Mateo-Opertti/ECU32/hardware/pcb/README.md

# PCB layout

| Archivo | Contenido |
|---|---|
| `ECU32_PCB_Layout.pdf` | Página 1: vista top (composite). Página 2: vista bottom |

Las capturas en PNG que se muestran en el README principal están en [`docs/images/pcb/`](../../docs/images/pcb/).

**Datos de la placa:** 2 capas, ~150 × 150 mm, fabricada en JLCPCB.

## Cómo regenerarlo

- Desde Altium: OutJob → **Documentation Outputs → PCB Prints**, salida a PDF.
- Para un dibujo de armado: **Assembly Outputs → Assembly Drawings**.
