Mateo-Opertti/ECU32/docs/images/README.md

# Imágenes

| Carpeta | Contenido | Nombre sugerido |
|---|---|---|
| `renders/` | Renders 3D de Altium | `ecu32-top.png`, `ecu32-bottom.png`, `ecu32-iso.png` |
| `pcb/` | Capturas 2D del layout | `ecu32-layout.png`, `ecu32-top-copper.png` |
| `diagrams/` | Diagrama de bloques inicial (Figura 1 del anteproyecto) y su fuente `.cddx` ([circuit-diagram.org](https://www.circuit-diagram.org)) | `diagrama-caja-negra.png` |
| `qr-pinout.png` | QR impreso en la serigrafía inferior (tiene el pinout viejo, ver el README principal) | — |
| `photos/` | Placa armada y separador del gabinete | `ecu32-assembled-top.jpg`, `ecu32-assembled-bottom.jpg` |

**Pautas:**

- PNG para renders y capturas; JPG para fotos.
- Que cada imagen pese **menos de 1 MB**, porque GitHub guarda cada versión para siempre. Achicá las fotos a ~1600 px de ancho.
- Nombres en minúsculas, con guiones y sin espacios.
