Mateo-Opertti/ECU32/docs/reports/README.md

# Documentos del PI3

| Archivo | Contenido |
|---|---|
| [`Anteproyecto.pdf`](Anteproyecto.pdf) | Anteproyecto: contexto, objetivos, arquitectura, requisitos (RQ-01 a RQ-25), cronograma, niveles de alcance, entregables, criterios de éxito (CE-01 a CE-25) y presupuesto inicial |

El informe final se agrega acá cuando esté listo.
