Mateo-Opertti/ECU32/hardware/3d/README.md

# Modelo 3D

| Archivo | Contenido |
|---|---|
| `ECU32.step` | Placa completa con componentes (STEP AP214, ~26 MB) |

Sirve para diseñar la carcasa (Fusion, SolidWorks, FreeCAD) y para verificar alturas e interferencias. Para verlo sin instalar nada se puede usar un visor online de STEP, como [3dviewer.net](https://3dviewer.net).

Los renders en PNG están en [`docs/images/renders/`](../../docs/images/renders/).

## Cómo regenerarlo

Desde Altium, con el `.PcbDoc` abierto: **File → Export → STEP 3D**, incluyendo los componentes con modelo 3D.
