Mateo-Opertti/ECU32/docs/images/diagrams/diagrama-caja-negra.png

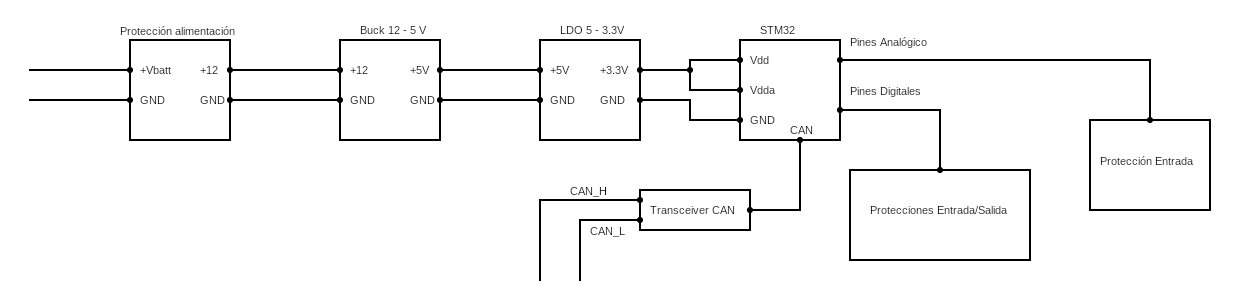
docs/images/diagrams/diagrama-caja-negra.png
