Mateo-Opertti/ECU32/docs/images/qr-pinout.png

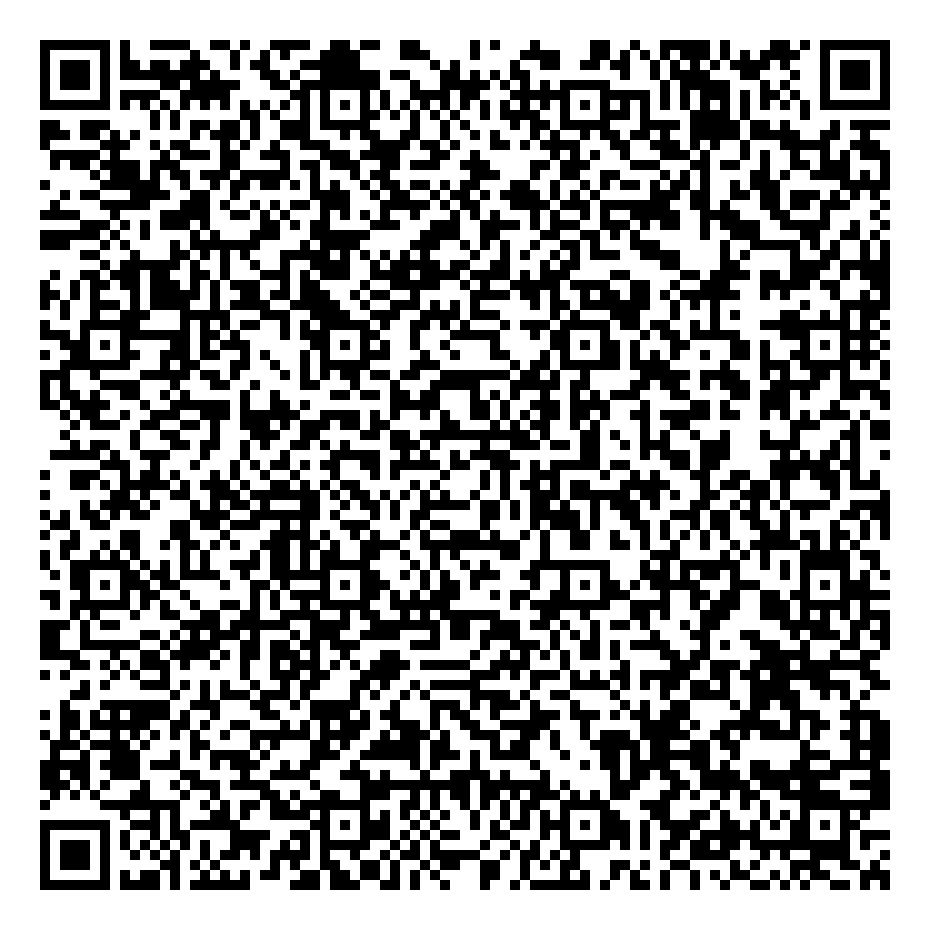
docs/images/qr-pinout.png
