Mateo-Opertti/ECU32/hardware/bom/ECU32_BOM.csv

Ítem | Cantidad | Designadores | Valor | Parte (MPN) | Fabricante | Descripción | Footprint | Notas
1 | 4 | C1, C32, C33, C34 | 10nF | Serie RCE5C1H (C0G, 50 V, radial) | Murata | Capacitor cerámico C0G 50 V radial 2,5 mm, AEC-Q200 | FP-RCE0DB-MFG | en la librería usa el MPN del de 10 pF (RCE5C1H100J0A2H03B); comprar el MPN del valor indicado; filtro de AN1–AN4: C32 (AN1), C1 (AN2), C34 (AN3), C33 (AN4)
2 | 2 | C2, C3 | 6pF | RCE5C1H6R0D0DBH03A |  | Cap Ceramic 6pF 50V C0G ±0.5pF Radial 2.5mm +125°C Ammo Pack | FP-RCE0DB-MFG
3 | 2 | C4, C5 | 10pF | RCE5C1H100J0A2H03B | Murata | Capacitor cerámico 10 pF C0G 50 V radial 2,5 mm, AEC-Q200 | FP-RCE0DB-MFG
4 | 11 | C6, C16, C20, C31, C35, C36, C37, C38, C39, C42, C44 | 100nF | Genérico |  | Capacitor cerámico through-hole | Capacitor cerámico TH-Footprint-1
5 | 3 | C7, C8, C40 | 10µF | Genérico |  | Capacitor cerámico through-hole | Capacitor cerámico TH-Footprint-1
6 | 3 | C9, C12, C13 | 22µF | Genérico |  | Capacitor cerámico through-hole | Capacitor cerámico TH-Footprint-1
7 | 1 | C10 | 10µF | ECA1HM100 | Panasonic | Aluminum Electrolytic Capacitor, 10 uF, +/- 20%, 50 V, -40 to 85 degC, 2-Pin THD, RoHS, Bulk | CAPPR55-200-1100X500X1200
8 | 1 | C11 | 15nF | Genérico |  | Capacitor cerámico through-hole | Capacitor cerámico TH-Footprint-1
9 | 1 | C14 | 330nF | Genérico |  | Capacitor cerámico through-hole | Capacitor cerámico TH-Footprint-1
10 | 2 | C15, C17 | 2.2µF | Genérico |  | Capacitor cerámico through-hole | Capacitor cerámico TH-Footprint-1
11 | 1 | C18 | 330µF | ECA1HHG331B |  | Aluminum Electrolytic Capacitors (Radial Lead Type) AEC-Q200 Qualified 330uF ±20% 50V | FP-RAD-TH-D_10_0_5-L_16_1-MFG
12 | 1 | C19 | 15nF | FG14C0G2A153JRT06 |  | ±5% 100V 15nF C0G Plugin Multilayer Ceramic Capacitors MLCC - Leaded ROHS | FG14C0G2A153JRT06-Footprint-1
13 | 2 | C21, C24 | 4.7nF | Serie RCE5C1H (C0G, 50 V, radial) | Murata | Capacitor cerámico C0G 50 V radial 2,5 mm, AEC-Q200 | FP-RCE0DB-MFG | en la librería usa el MPN del de 10 pF (RCE5C1H100J0A2H03B); comprar el MPN del valor indicado
14 | 3 | C22, C23, C30 | 100nF | Serie RCE5C1H (C0G, 50 V, radial) | Murata | Capacitor cerámico C0G 50 V radial 2,5 mm, AEC-Q200 | FP-RCE0DB-MFG | en la librería usa el MPN del de 10 pF (RCE5C1H100J0A2H03B); comprar el MPN del valor indicado
15 | 4 | C25, C26, C27, C28 | 22pF | Serie RCE5C1H (C0G, 50 V, radial) | Murata | Capacitor cerámico C0G 50 V radial 2,5 mm, AEC-Q200 | FP-RCE0DB-MFG | en la librería usa el MPN del de 10 pF (RCE5C1H100J0A2H03B); comprar el MPN del valor indicado
16 | 1 | C29 | 220pF | C322C221K5R5TA | KEMET | Capacitor cerámico radial 220 pF 50 V | FP-RCE0DB-MFG
17 | 1 | C41 | 1µF | Genérico |  | Capacitor cerámico through-hole | Capacitor cerámico TH-Footprint-1
18 | 1 | C45 | 10nF | Genérico |  | Capacitor cerámico through-hole | Capacitor cerámico TH-Footprint-1
19 | 8 | D1, D6, D13, D18, D25, D26, D30, D35 |  | ESD2CAN36DBZRQ1 |  | Automotive, two-channel bidirectional 36V ESD protection diode 3-SOT-23 -55 to 150 | SOT-23-3_DBZ_TEX
20 | 16 | D2, D4, D7, D9, D12, D14, D17, D19, D28, D29, D31, D32, D33, D34, D36, D37 |  | BAS40LT1G | On Semiconductor | Schottky Barrier Diode, 3-Pin SOT-23, Pb-Free, Tape and Reel | ONSC-SOT-23-3-318-08_V
21 | 8 | D3, D5, D8, D10, D11, D15, D16, D20 |  | BZX84C4V7LT1G | On Semiconductor | Zener Voltage Regulator, 225 mW, 3-Pin SOT-23, Pb-Free, Tape and Reel | ONSC-SOT-23-3-318-08_V
22 | 1 | D21 |  | SMBJ58A | Littelfuse Inc | TVS DIODE 58V 93.6V DO214AA | FP-SMBJ-MFG
23 | 1 | D22 |  | BZT52C18-7-F | Diodes Inc. | DIODE ZENER 18V 500MW SOD123 | FP-SOD123-MFG
24 | 1 | D23 |  | SMBJ28A | Littelfuse Inc | TVS DIODE 28V 45.4V DO214AA | FP-SMBJ-MFG
25 | 1 | D24 |  | STPS2H100AY |  | DIODE SCHOTTKY 100V 2A SMA | FP-SMA-MFG
26 | 1 | D27 |  | MMSD4148T3G | On Semiconductor | Switching Diode, 2-Pin SOD-123, Pb-Free, Tape and Reel | ONSC-SOD-123-2-425-04_V
27 | 1 | D38 |  | B340A-13-F |  | DIODE SCHOTTKY 40V 3A SMA | FP-SMA-MFG
28 | 1 | D39 |  | PESD5V0L4UG,115 |  | Tvs Diodes & Esd Suppressors; PESD5V0L4UG, 115; Nexperia; 5 V; 5; 13 V; 6.8 V | PESD5V0L4UG,115-Footprint-1
29 | 1 | D40 |  | ESD9X5.0ST5G | On Semiconductor | Transient Voltage Suppressor, Micro-Packaged Diode for ESD Protection, 2-Pin SOD-923, Pb-Free, Tape and Reel | ONSC-SOD-923-2-514AA-01_V
30 | 4 | DS1, DS2, DS3, DS4 |  | G502DC | Shenzhen CGX | Green LED, 80 mW, 20 mA, -25 to 85 degC, 2-Pin THD | CGX-G502DC
31 | 1 | F1 |  | Portafusible 5×20 mm |  | Wsk-open Fuse Holder 5X20MM Clip | 9.52017E+14-Footprint-1 | el MPN de la librería se exportó como número (9.52017E+14)
32 | 1 | J1 |  | TBL002A-350-08GR-2OR |  | 1~24 Poles, Screwless, 45°, 3.50 Pitch, 24~20 (AWG), Terminal Block Connector | CUI_TBL002A-350-08GR-2OR
33 | 2 | J2, J? |  | SSK03-MPH-254-B10 |  | 2.54MM MALE HEADER 2X10PIN, STRA | SAMESKY_SSK03-MPH-254-B10 | designador sin asignar en el esquemático
34 | 1 | J3 |  | TBL002A-350-05GR-2OR |  | 1~24 Poles, Screwless, 45°, 3.50 Pitch, 24~20 (AWG), Terminal Block Connector | TBL002A-350-05GR-2OR-Footprint-1
35 | 1 | J4 |  | TBL002A-350-04GR-2OR |  | 1~24 Poles, Screwless, 45°, 3.50 Pitch, 24~20 (AWG), Terminal Block Connector | CUI_TBL002A-350-04GR-2OR
36 | 1 | J7 |  | TBL002A-350-02GR-2OR |  | 1~24 Poles, Screwless, 45°, 3.50 Pitch, 24~20 (AWG), Terminal Block Connector | CUI_TBL002A-350-02GR-2OR
37 | 1 | L1 | 10µH | HPAL1V1040-100-R |  | General Purpose Inductor, 10uH, 20%, 1 Element, Powdered Iron-Core, SMD, 4539 | INDC115100X400M
38 | 1 | L2 | 100µH | SRN6045TA-101M |  | Ind Power Semi-Shielded Wirewound 100uH ±20% 1MHz 15 Q-Factor Ferrite 0.92A T/R | SRN6045TA-101M-Footprint-1
39 | 12 | P1, P2, P3, P4, P5, P6, P7, P8, P9, P10, P11, P12 |  | TSW-102-26-F-S | Samtec | 0.025" SQ Post Header, Through-hole, Vertical, -55 to 125 degC, 2.54 mm Pitch, 2-Pin, Male, RoHS | SMTC-TSW-102-26-XX-S
40 | 1 | Q1 |  | BUK7K15-80EX |  | Mosfet, Aec-Q101, Dual N-Ch, 80V, Sot1205 Rohs Compliant: Yes | BUK7K15-80EX-Footprint-1
41 | 10 | R1, R2, R3, R4, R8, R9, R10, R11, R48, R70 | 4.7kΩ | Serie MFR-25 (1 %, 1/4 W) | Yageo | Resistencia axial 1 %, 0,25 W | RESA60-630X240
42 | 3 | R5, R26, R34 | 1kΩ | Serie MFR-25 (1 %, 1/4 W) | Yageo | Resistencia axial 1 %, 0,25 W | RESA60-630X240
43 | 11 | R6, R7, R21, R41, R42, R50, R51, R60, R61, R71, R72 | 10kΩ | Serie MFR-25 (1 %, 1/4 W) | Yageo | Resistencia axial 1 %, 0,25 W | RESA60-630X240
44 | 16 | R12, R13, R14, R15, R43, R44, R45, R46, R47, R55, R56, R57, R63, R65, R67, R69 | 680Ω | Serie MFR-25 (1 %, 1/4 W) | Yageo | Resistencia axial 1 %, 0,25 W | RESA60-630X240
45 | 2 | R16, R52 | 47kΩ | Serie MFR-25 (1 %, 1/4 W) | Yageo | Resistencia axial 1 %, 0,25 W | RESA60-630X240
46 | 2 | R17, R18 | 220kΩ | Serie MFR-25 (1 %, 1/4 W) | Yageo | Resistencia axial 1 %, 0,25 W | RESA60-630X240
47 | 1 | R19 | 5.6kΩ | Serie MFR-25 (1 %, 1/4 W) | Yageo | Resistencia axial 1 %, 0,25 W | RESA60-630X240
48 | 1 | R20 | 39kΩ | Serie MFR-25 (1 %, 1/4 W) | Yageo | Resistencia axial 1 %, 0,25 W | RESA60-630X240
49 | 3 | R22, R49, R59 | 330Ω | Serie MFR-25 (1 %, 1/4 W) | Yageo | Resistencia axial 1 %, 0,25 W | RESA60-630X240
50 | 1 | R23 | 110kΩ | Serie MFR-25 (1 %, 1/4 W) | Yageo | Resistencia axial 1 %, 0,25 W | RESA60-630X240
51 | 1 | R24 | 100Ω | Serie MFR-25 (1 %, 1/4 W) | Yageo | Resistencia axial 1 %, 0,25 W | RESA60-630X240
52 | 1 | R25 | 1.27kΩ | Serie MFR-25 (1 %, 1/4 W) | Yageo | Resistencia axial 1 %, 0,25 W | RESA60-630X240
53 | 1 | R27 | 4.02kΩ | Serie MFR-25 (1 %, 1/4 W) | Yageo | Resistencia axial 1 %, 0,25 W | RESA60-630X240
54 | 1 | R28 | ‹completar› | Serie MFR-25 (1 %, 1/4 W) | Yageo | Resistencia axial 1 %, 0,25 W | RESA60-630X240 | AN2: R serie del divisor (filtro: C1)
55 | 4 | R29, R30, R31, R32 | 60Ω | Serie MFR-25 (1 %, 1/4 W) | Yageo | Resistencia axial 1 %, 0,25 W | RESA60-630X240
56 | 1 | R33 | ‹completar› | Serie MFR-25 (1 %, 1/4 W) | Yageo | Resistencia axial 1 %, 0,25 W | RESA60-630X240 | AN2: R a GND del divisor (filtro: C1)
57 | 1 | R35 | ‹completar› | Serie MFR-25 (1 %, 1/4 W) | Yageo | Resistencia axial 1 %, 0,25 W | RESA60-630X240 | AN1: R a GND del divisor (filtro: C32)
58 | 1 | R36 | ‹completar› | Serie MFR-25 (1 %, 1/4 W) | Yageo | Resistencia axial 1 %, 0,25 W | RESA60-630X240 | AN1: R serie del divisor (filtro: C32)
59 | 1 | R37 | ‹completar› | Serie MFR-25 (1 %, 1/4 W) | Yageo | Resistencia axial 1 %, 0,25 W | RESA60-630X240 | AN4: R serie del divisor (filtro: C33)
60 | 1 | R38 | ‹completar› | Serie MFR-25 (1 %, 1/4 W) | Yageo | Resistencia axial 1 %, 0,25 W | RESA60-630X240 | AN4: R a GND del divisor (filtro: C33)
61 | 1 | R39 | ‹completar› | Serie MFR-25 (1 %, 1/4 W) | Yageo | Resistencia axial 1 %, 0,25 W | RESA60-630X240 | AN3: R a GND del divisor (filtro: C34)
62 | 1 | R40 | ‹completar› | Serie MFR-25 (1 %, 1/4 W) | Yageo | Resistencia axial 1 %, 0,25 W | RESA60-630X240 | AN3: R serie del divisor (filtro: C34)
63 | 2 | R53, R54 | 7.5kΩ | Serie MFR-25 (1 %, 1/4 W) | Yageo | Resistencia axial 1 %, 0,25 W | RESA60-630X240
64 | 5 | R58, R62, R64, R66, R68 | 1.5kΩ | Serie MFR-25 (1 %, 1/4 W) | Yageo | Resistencia axial 1 %, 0,25 W | RESA60-630X240
65 | 1 | S1 |  | TS02-66-43-BK-160-LCR-D |  | 6 x 6 mm, 4.3 mm Actuator Height, 160 gf, Black, Long Crimped, Through Hole, SPST, Tactile Switch | SW_TS02-66-43-BK-160-LCR-D
66 | 2 | SW1, SW3 |  | 1825255-1 | TE Connectivity | Slide Switch, SPDT, 0.3A, 125 V, -20 to 85 degC, 5-Pin THD, RoHS, Tray | TECO-1825255-1_V
67 | 2 | SW2, SW4 |  | SLW-111629-7A-D |  | Switch Slide ON ON DPDT Raised Slide 0.5A 50VDC 10000Cycles PC Pins Thru-Hole Box | SLW-111629-7A-D-Footprint-1
68 | 1 | U1 |  | STM32G491VCT6 |  | MCU 32-Bit STM32G491 ARM Cortex-M4F RISC 256KB Flash 1.71V to 3.6V 100-Pin LQFP Tray | STM32G491VCT6-Footprint-1
69 | 1 | U2 |  | LM74720QDRRRQ1 |  | Automotive, low IQ ideal diode controller with active rectification and load dump protection 12-WSON -40 to 125 | LM74720QDRRRQ1-Footprint-1
70 | 1 | U3 |  | AP64202SP-13 | Diodes Inc. | Buck síncrono 2 A, 3,8–40 V | IC8_AP64202SP-13_DIO
71 | 1 | U4 |  | TLE42744GS V33 | Infineon | Low Drop Linear Voltage Regulator, 4.7 to 40 V Supply, 3.3 V Output, -40 to 150 degC, PG-SOT223 (SC-73), Reel, Green | INF-PG-SOT223_SC-73_M
72 | 1 | U5 |  | SN74LV244AQDGSRQ1 |  | Automotive eight-channel 2-V to 5.5-V buffers with tri-state outputs 20-VSSOP -40 to 125 | VSSOP20_DGS_TEX
73 | 1 | U6 |  | TCAN1046AVDYYRQ1 |  | Enhanced Automotive Dual Can Tra / 2/2 Transceiver Canbus 14-SOT-23-THIN | TCAN1046AVDYYRQ1-Footprint-1
74 | 1 | U7 |  | TLIN4029ADRQ1 |  | Local interconnect network (LIN) transceiver with dominant state timeout and ±70V fault protection 8-SOIC -40 to 125 | SOIC127P600X175-8M
75 | 1 | U8 |  | TLV9164IDR |  | Quad, 16-V, 11-MHz rail-to-rail input and output low-offset-voltage operational amplifier 14-SOIC -40 to 125 | TLV9164IDR-Footprint-1
76 | 1 | U9 |  | ESP32-DEVKIT-V1 |  | Dual core, Wi-Fi: 2.4 GHz up to 150 Mbits/s,BLE (Bluetooth Low Energy) and legacy Bluetooth, 32 bits, Up to 240 MHz | MODULE_ESP32_DEVKIT_V1
77 | 1 | X1 |  | ABS07AIG-32.768KHZ-6-1-T |  | Crystal 32.768kHz ±10ppm (Tol) 6pF FUND 70kΩ Automotive 2-Pin Mini-CSMD T/R | FP-ABS07AIG-MFG
78 | 1 | X2 |  | ABM8AIG-16.000MHZ-8-1Z-T |  | Crystal 16MHz ±10ppm (Tol) ±50ppm (Stability) 8pF FUND 70Ohm Automotive AEC-Q200 4-Pin CSMD T/R | ABM8AIG-16.000MHZ-8-1Z-T-Footprint-1
