Mateo-Opertti/ECU32/hardware/3d/ECU32.step

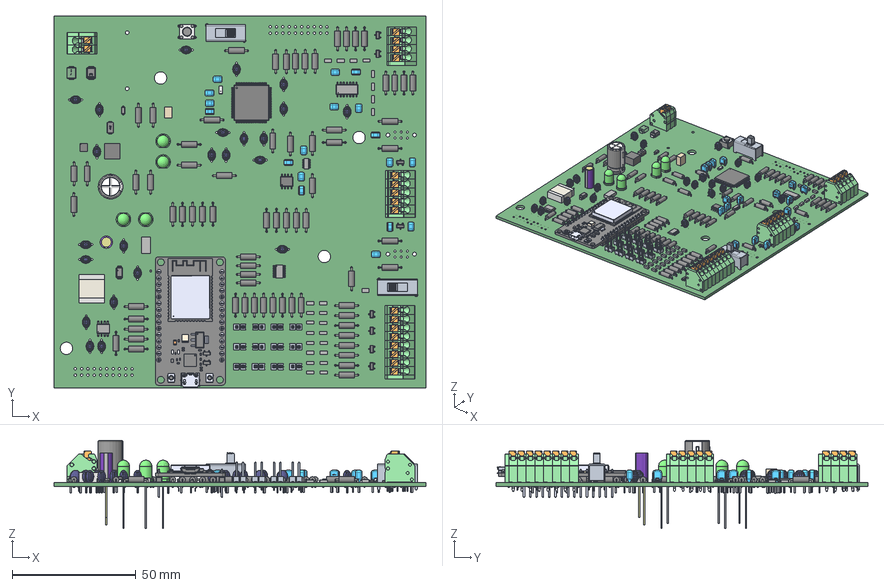
[picture p14: CAD file, 2026-10-31]
hardware/3d/ECU32.step
150.0 x 150.0 x 35.5 mm
TSW-XX-S_10 POS x 12
T-1RS7-XX-X-X_DEFAULT x 24
Extruded x 45
name
Diod Logo
Logo x 19
Leads x 18
MainBody x 18
TBL002A-350 - END CAP_Green x 4
TBL002A-350 - BODY A_Green x 10
TBL002A-350 - BODY B_Green x 9
TBL002A-350 - PUSH BUTTON A_Orange x 10
TBL002A-350 - PUSH BUTTON B_Orange x 9
Package
Lid
Terminals
Leader x 8
c-1825255-1-a-3d x 2
STMicroelectronics STPS2L60A 1
STMicroelectronics STPS2L60A 2
STMicroelectronics STPS2L60A 2_MIR
STMicroelectronics
Leg x 2
Littelfuse
bar
diodes Logo x 1.6
diodes Logo x 1.6 - 1
marking
bottom
logo
polarity marking
top
terminal
