Mateo-Opertti/ECU32/hardware/enclosure/separador.stl

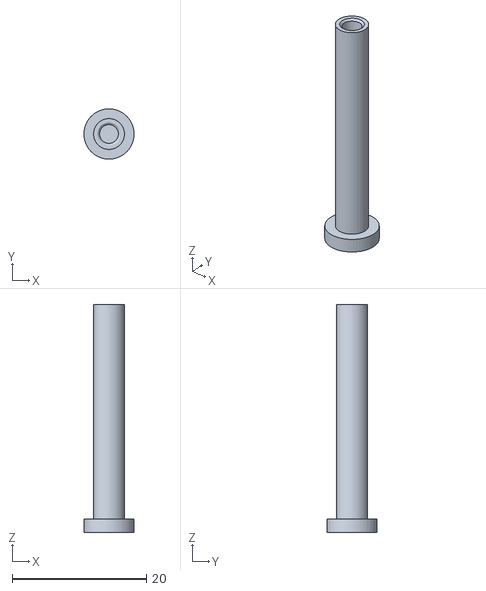
[picture p15: CAD file, 2026-10-31]
hardware/enclosure/separador.stl
7.50 x 7.49 x 34.0
