Mateo-Opertti/ECU32/docs/manual/README.md

# Manual de usuario

`UM-ECU32.pdf`: manual de usuario compilado.
Opcionalmente, las fuentes LaTeX en una subcarpeta `src/`.
