Mateo-Opertti/ECU32/hardware/pcb/ECU32_PCB_Layout.pdf

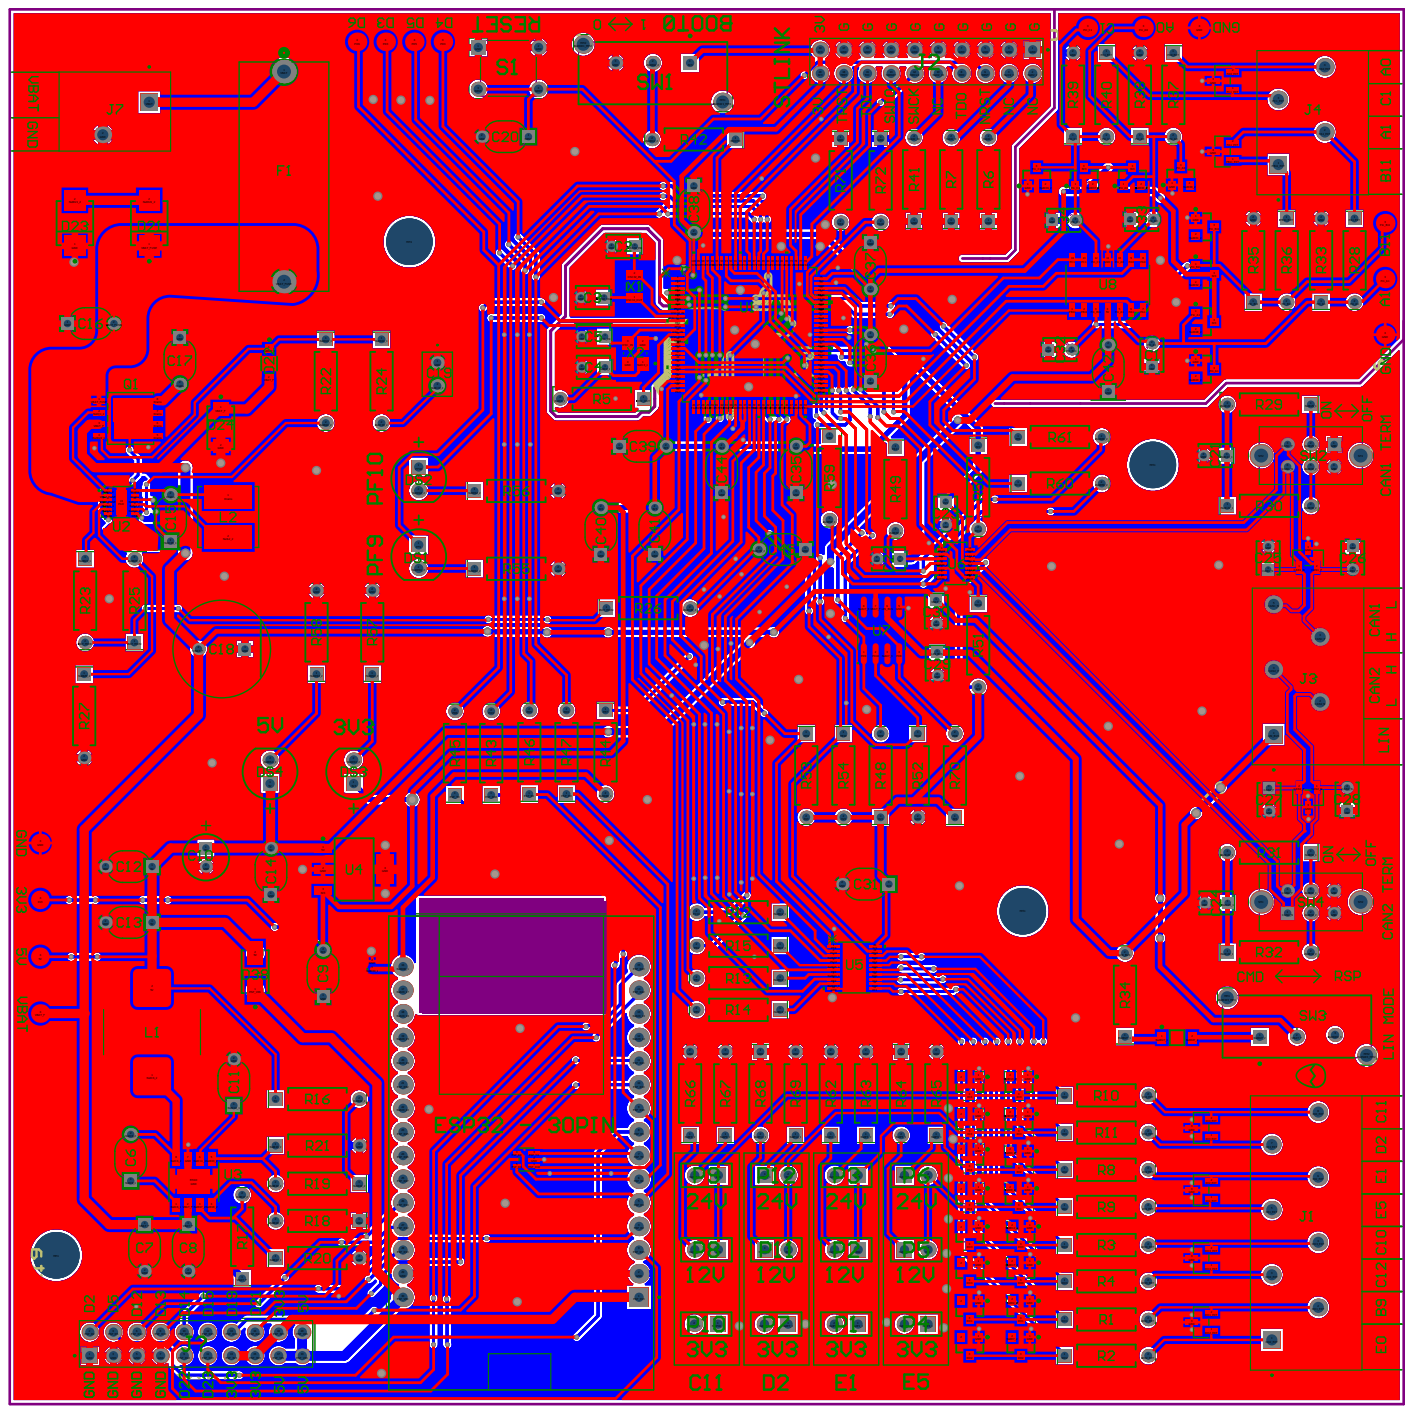
[picture p16: page 1]
1 GND; 15 GND; 17 GND; 16 TDI; 18 TRST; 1 NetR12_1; 2 GND; 1 NetR15_1; 1 ESP_D18; 1 ESP_D4; 1 ESP_RX; MH2 NetSW 1_MH2; 1 NetP10_1; 2 NetP10_2; 2 NetP7_2; 1 NetP9_2; 2 NetP11_1; 1 NetP8_2; 1 BA T_MON; 2 NetR42_2; 2 NetR59_2; 2 NetC 19_2; 2 NetC 4_1; 1 O SC _OUT; 2 NetR30_2; 1 Pin_A 1; 1 PA 1_EXT; 8 DI4_EXT; 5 NetR31_1; 6 GND; 2 DO 2_EXT; 1 Pin_C 1; 12 SW CLK; 4 NetJ2_4; 6 NRST; 8 TDO; 10 NetJ2_10; 2 NetJ2_2; 5 GND; 13 GND; 11 GND; 9 GND; 7 GND; GND; 2 Pin_A 1; 2 GND 2 Pin_C 1; 2 Pin_A 0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

DI4 DI4 2 2 | GND GND 1 1 3 3 | | 2 2 | 3 3 1 1 1 1 1 1

DI3 DI3 2 2 DI2 DI2 2 2 | GND GND 1 1 3 3 | 3 3 1 1 1 1 1

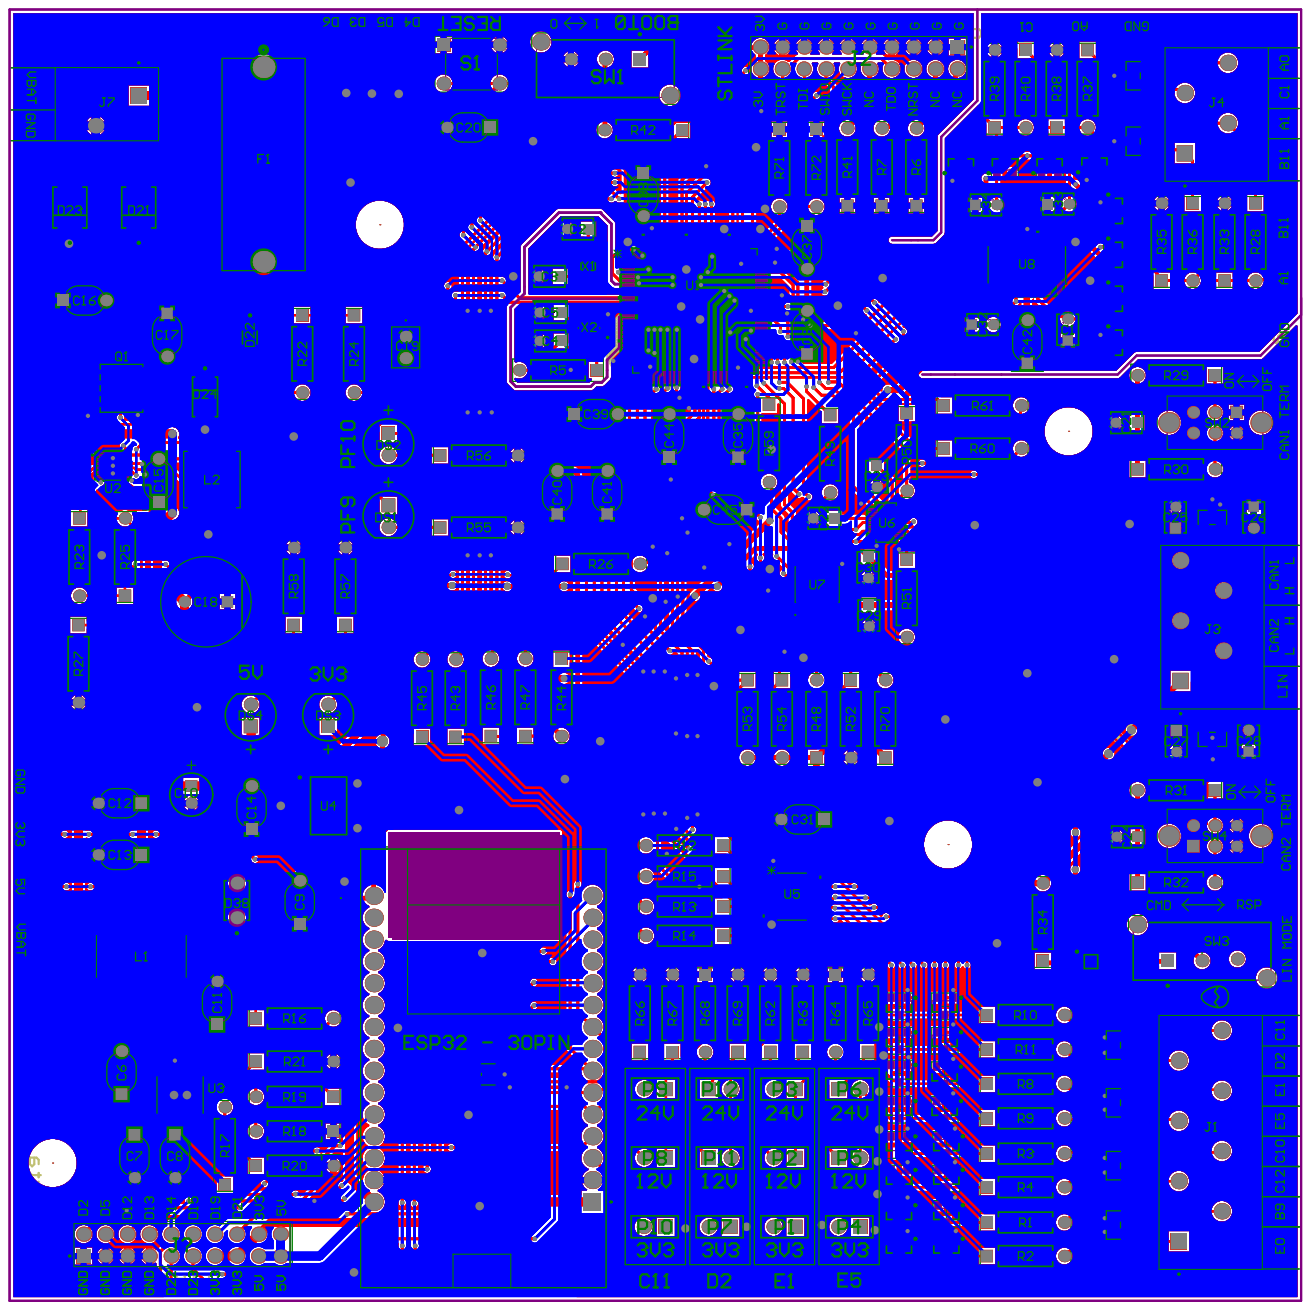
[picture p17: page 2]
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
