Mateo-Opertti/ECU32/hardware/schematic/ECU32_Schematic.pdf

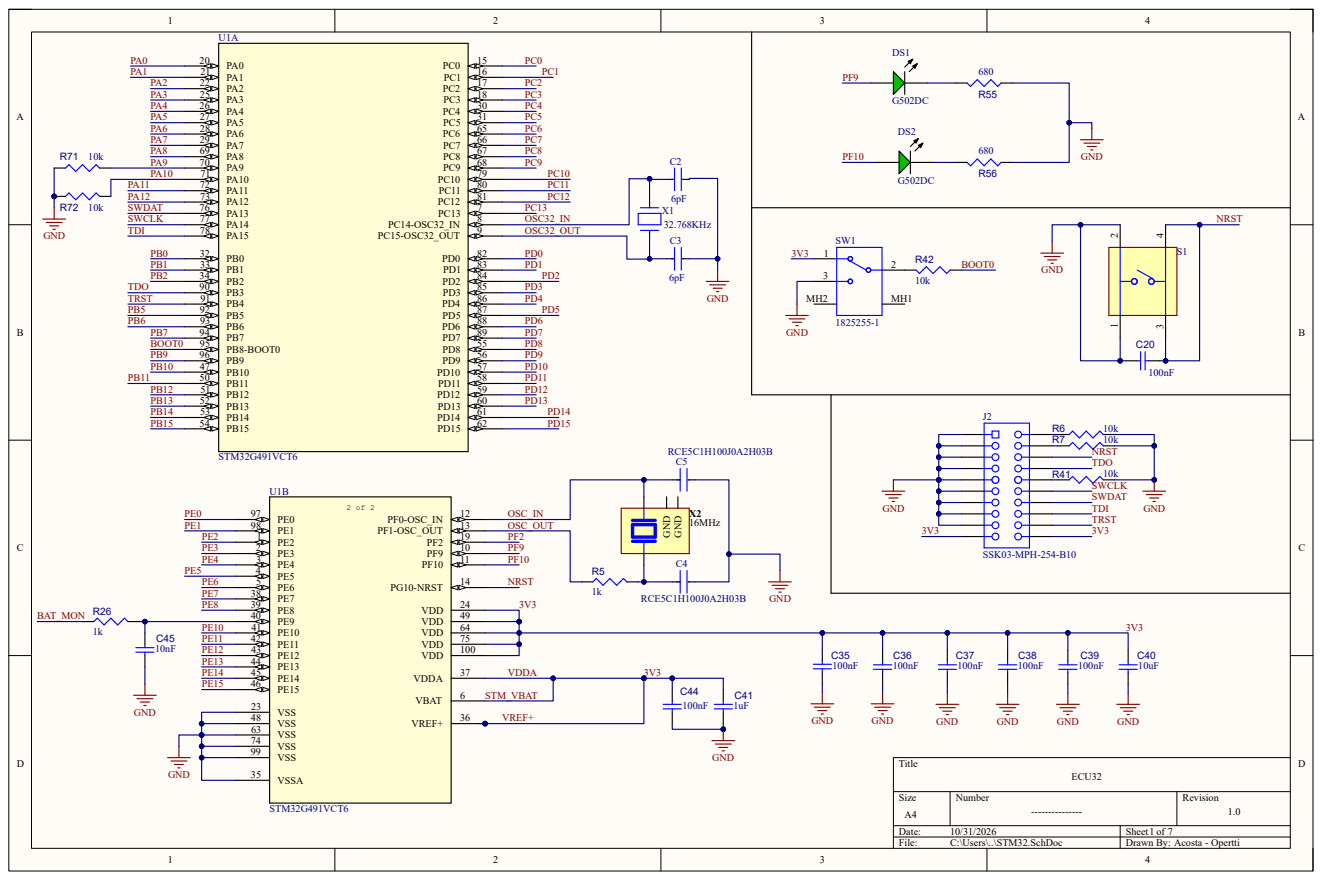
[picture p18: page 1]

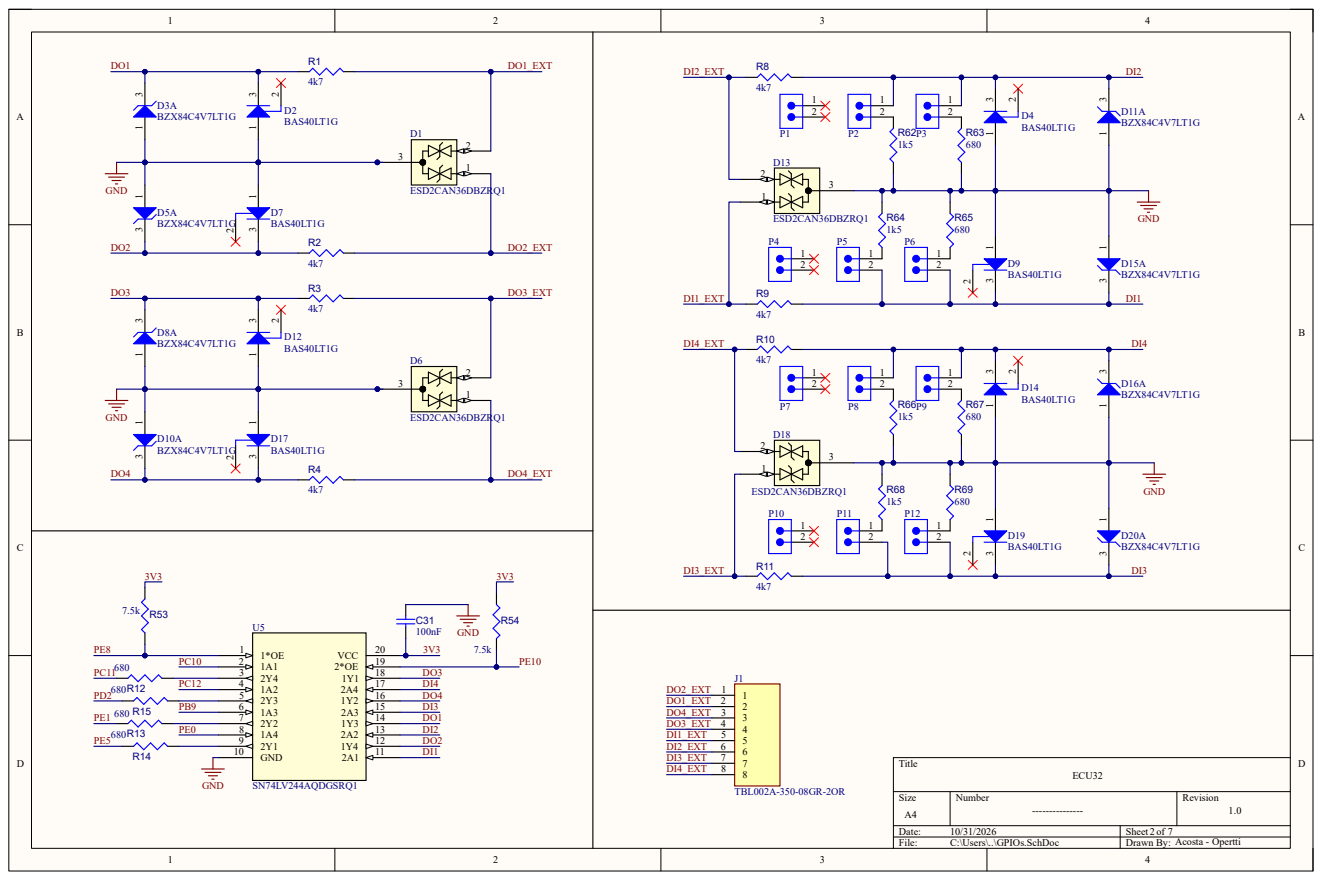
[picture p19: page 2]

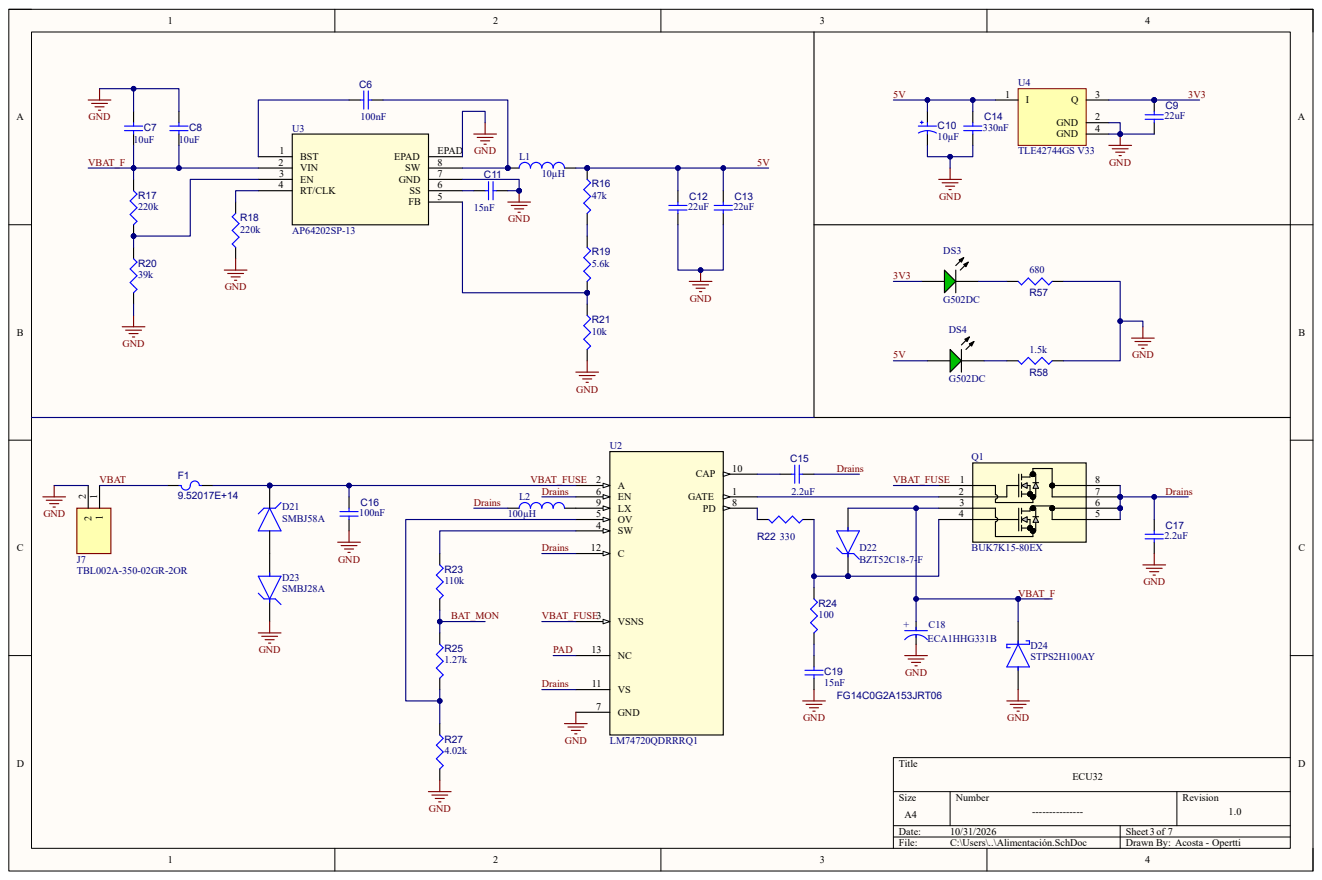
[picture p20: page 3]

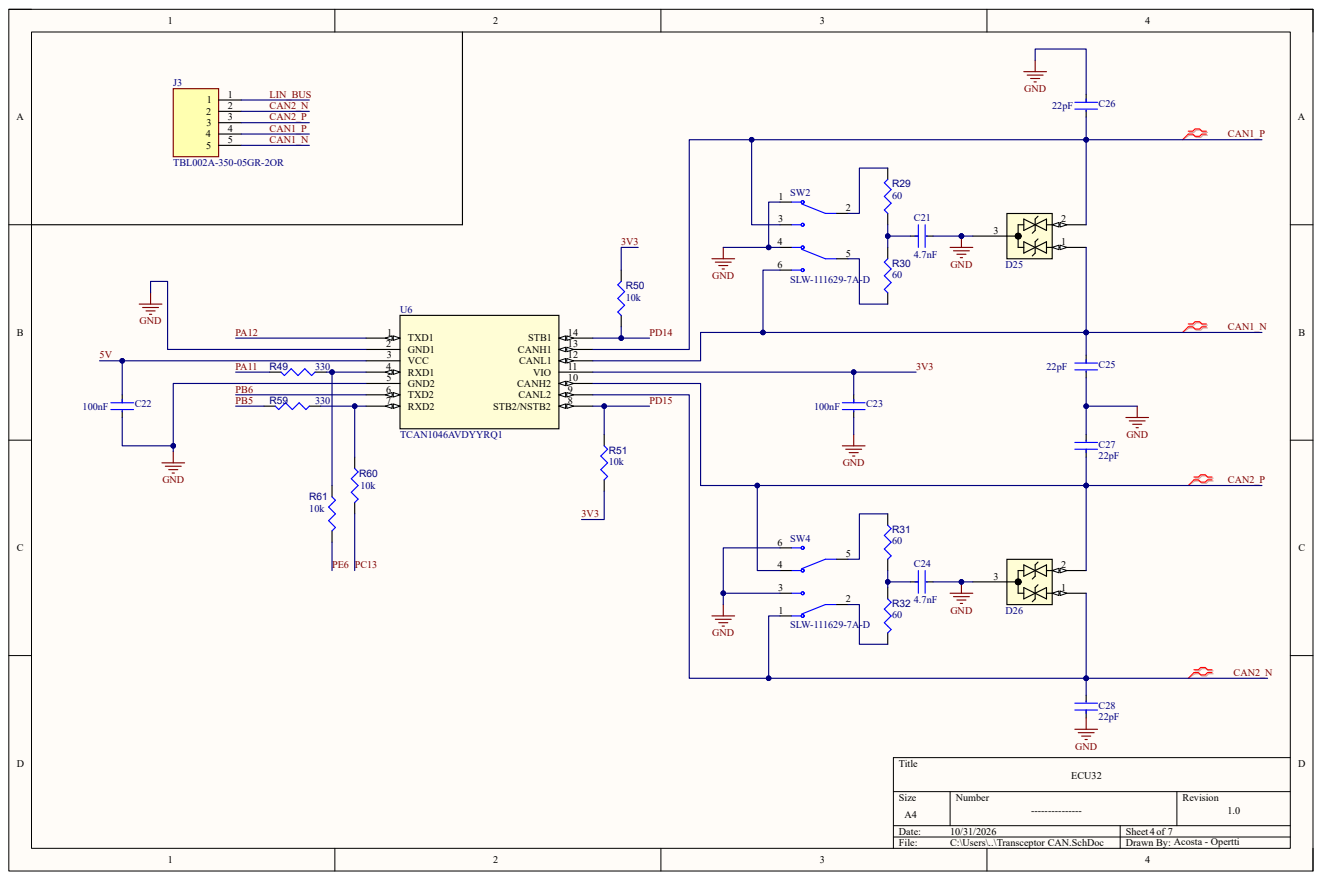
[picture p21: page 4]

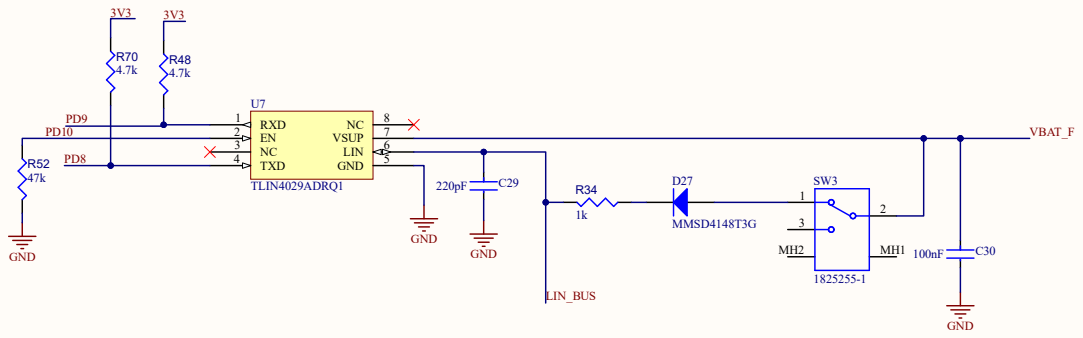
[picture p22: page 5]

3V3 1 3

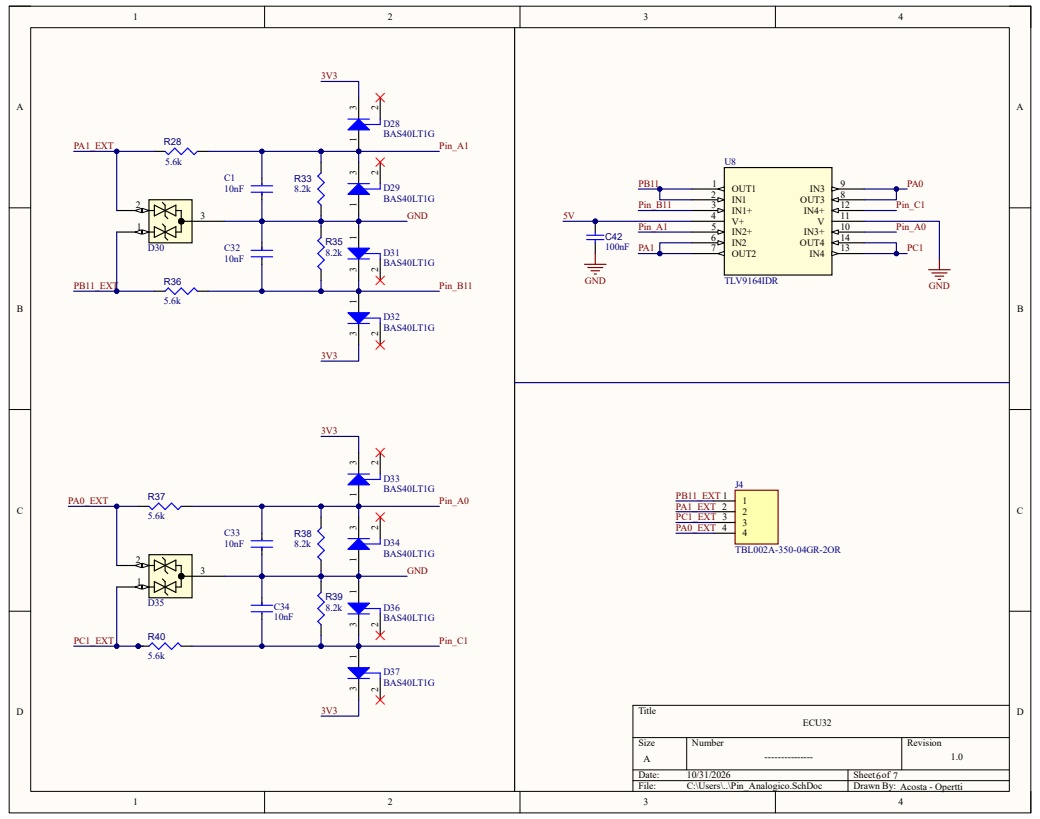
[picture p23: page 6]

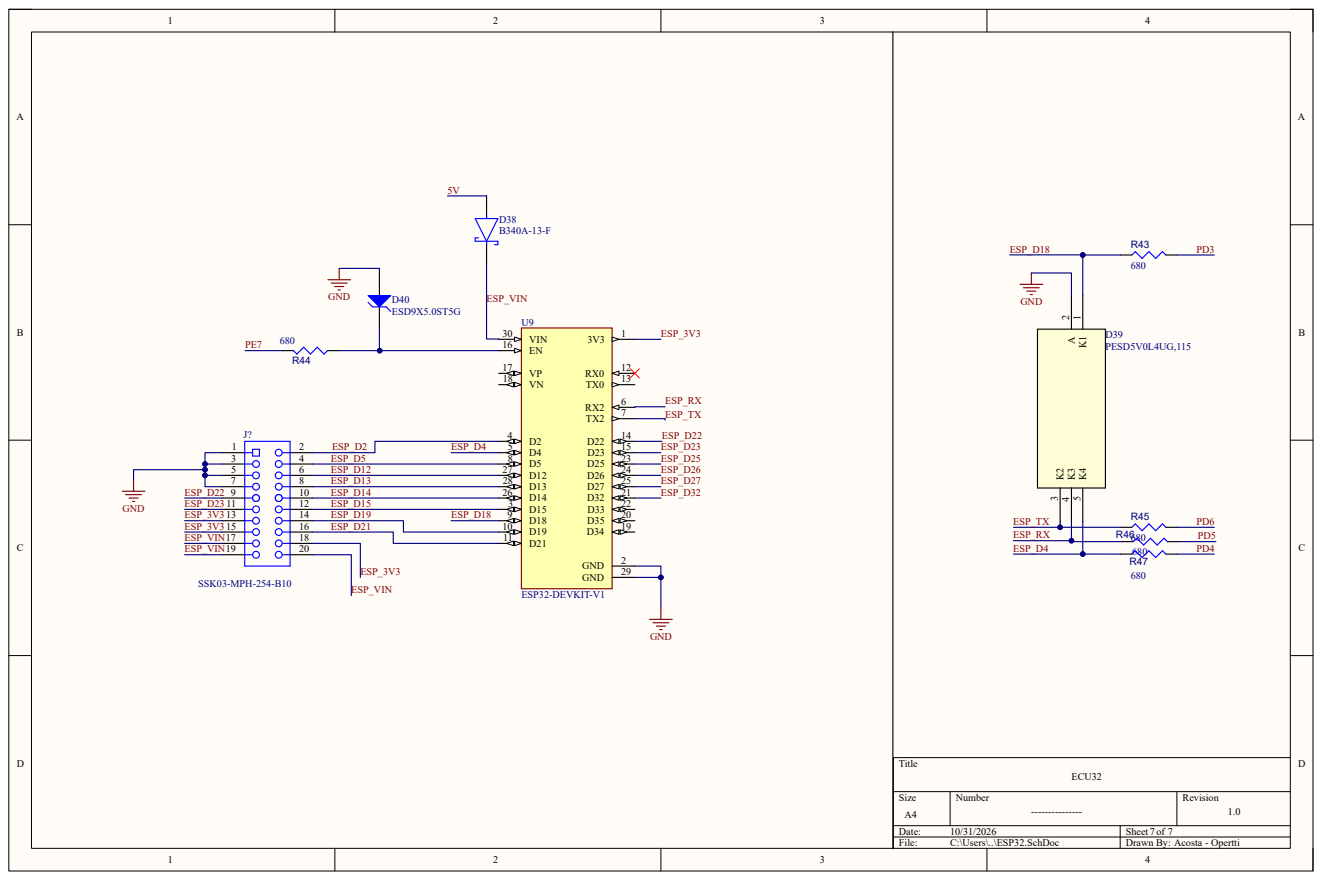
[picture p24: page 7]
