Mateo-Opertti/ECU32/firmware/Apps/universal/p_lin_maestro.c

// LIN_Maestro (la otra placa corre LIN_Esclavo)
// Cada 50 ms alterna entre dos tramas:
// - ID 0x10: el maestro manda 4 bytes con un contador (los recibe el esclavo)
// - ID 0x11: el maestro manda solo el header y el esclavo responde 4 bytes
//   [contador, ~contador, 0xA5, 0x5A] con el último contador que recibió
// LEDs: el verde (PF10) alterna con cada respuesta correcta del esclavo,
//       el rojo (PF9) se prende si la respuesta llega mal o pasan 500 ms sin una buena
// En la placa maestra va SW3 cerrado (pull-up de master LIN)
//
// Consola:
// - cada 1 s (si "resumen on"): tramas 0x10 mandadas y respuestas 0x11 buenas por segundo,
//   errores, última respuesta buena y errores de eco
// - en el momento: el esclavo deja de responder o vuelve, y el motivo de cada falla
//   (break, eco, timeout, checksum o datos)
// - con "traza on": cada trama 0x10 mandada y cada respuesta 0x11

#define LM_PERIODO_MS 50U
#define LM_RESUMEN_MS 1000U

enum { LM_ESPERA, LM_BREAK, LM_TX, LM_RX };

static volatile uint32_t lm_tx_count;  // tramas 0x10 enviadas
static volatile uint32_t lm_resp_ok;   // respuestas 0x11 del esclavo correctas
static volatile uint32_t lm_resp_err;  // respuestas que no llegaron o llegaron mal
// Errores por tipo (COM-03 pide 0 de checksum, sync y respuesta ausente)
static volatile uint32_t lm_e_break, lm_e_eco, lm_e_sin_resp, lm_e_chk, lm_e_datos;

static uint32_t lm_estado, lm_t0, lm_t_ok;
static uint8_t lm_cont;
static int lm_toca_respuesta, lm_error;

// Consola
static limite_t lm_lim;
static int lm_caido;
static uint32_t lm_err_caida;
static uint8_t lm_ultima[LIN_LEN + 1];
static int lm_hay_ultima;
static uint32_t lm_t_res, lm_tx_res, lm_ok_res;

static void lm_init(void)
{
    lin_hw_init();
    lm_tx_count = lm_resp_ok = lm_resp_err = 0;
    lm_e_break = lm_e_eco = lm_e_sin_resp = lm_e_chk = lm_e_datos = 0;
    lm_estado = LM_ESPERA;
    lm_cont = 0;
    lm_toca_respuesta = 0;
    lm_error = 0;
    lm_t0 = lm_t_ok = ticks;

    lm_lim.usado = 0;
    lm_caido = 0;
    lm_hay_ultima = 0;
    lm_t_res = ticks;
    lm_tx_res = lm_ok_res = 0;
}

// Fin de una trama. ok solo importa en la 0x11
static void lm_fin(int ok)
{
    if (lm_toca_respuesta) {
        if (ok) {
            lm_resp_ok++;
            lm_t_ok = ticks;
            lm_error = 0;
            led_alternar(LED_VERDE);
            if (lm_caido) {
                cprintf("lin_maestro: el esclavo volvio (%u pedidos sin respuesta buena)\n", lm_resp_err - lm_err_caida);
                lm_caido = 0;
            }
        } else {
            lm_resp_err++;
            lm_error = 1;
        }
        lm_cont++;
    }
    lm_toca_respuesta = !lm_toca_respuesta;
    lm_estado = LM_ESPERA;
}

static void lm_step(void)
{
    int r;
    uint8_t id = lm_toca_respuesta ? LIN_ID_ESCLAVO : LIN_ID_MAESTRO;

    switch (lm_estado) {
    case LM_ESPERA:
        if ((ticks - lm_t0) < LM_PERIODO_MS) break;
        lm_t0 = ticks;
        lin_flush();
        USART_RQR(USART3_BASE) = RQR_SBKRQ;  // break
        lin.t = ticks;
        lm_estado = LM_BREAK;
        break;

    case LM_BREAK:
        if ((USART_ISR(USART3_BASE) & ISR_LBDF) && !(USART_ISR(USART3_BASE) & ISR_SBKF)) {
            lin_flush();  // descarta el 0x00 con error de framing que deja el break
            uint8_t pid = lin_pid(id);
            lin.tx[0] = LIN_SYNC;
            lin.tx[1] = pid;
            lin.ntx = 2;
            if (!lm_toca_respuesta) {  // trama 0x10: header, datos y checksum
                for (uint32_t i = 0; i < LIN_LEN; i++) lin.tx[2 + i] = (uint8_t)(lm_cont + i);
                lin.tx[2 + LIN_LEN] = lin_checksum(pid, &lin.tx[2], LIN_LEN);
                lin.ntx = 3 + LIN_LEN;
            }
            lin_empezar_tx();
            lm_estado = LM_TX;
        } else if ((ticks - lin.t) > LIN_BYTE_TIMEOUT_MS) {
            lm_e_break++;
            if (limite_ok(&lm_lim)) {
                cputs("lin_maestro: no se pudo mandar el break (el USART3 no ve su propio break: "
                      "revisar EN = PD10 y el transceptor)\n");
            }
            lm_fin(0);
        }
        break;

    case LM_TX:
        r = lin_tx_step();
        if (r < 0) {
            lm_e_eco++;
            if (limite_ok(&lm_lim)) lin_explicar_eco("lin_maestro");
            lm_fin(0);
        } else if (r > 0) {
            if (!lm_toca_respuesta) {
                lm_tx_count++;
                if (traza_activa) {
                    lin_traza(LIN_ID_MAESTRO, "tx", &lin.tx[2], LIN_LEN);
                    cputs("\n");
                }
                lm_fin(1);
            } else {
                lin_empezar_rx(LIN_LEN + 1);  // el esclavo completa con datos y checksum
                lm_estado = LM_RX;
            }
        }
        break;

    default:  // LM_RX
        r = lin_rx_step();
        if (r < 0) {
            lm_e_sin_resp++;
            if (limite_ok(&lm_lim)) {
                cprintf("lin_maestro: el esclavo no responde a 0x11 (llegaron %u de %u bytes)\n", lin.irx, LIN_LEN + 1);
            }
            lm_fin(0);
        } else if (r > 0) {
            const uint8_t *d = lin.rx;
            uint8_t chk = lin_checksum(lin_pid(LIN_ID_ESCLAVO), d, LIN_LEN);
            int chk_ok = d[LIN_LEN] == chk;
            int datos_ok = d[0] == lm_cont && d[1] == (uint8_t)~d[0] && d[2] == 0xA5 && d[3] == 0x5A;
            if (traza_activa) {
                lin_traza(LIN_ID_ESCLAVO, "rx", d, LIN_LEN);
                cputs(chk_ok && datos_ok ? "  OK\n" : "  MAL\n");
            }
            if (!chk_ok) {
                lm_e_chk++;
                if (limite_ok(&lm_lim)) {
                    cprintf("lin_maestro: respuesta 0x11 con checksum mal: llego 0x%02x, se esperaba 0x%02x\n",
                            d[LIN_LEN], chk);
                }
            } else if (!datos_ok) {
                lm_e_datos++;
                if (limite_ok(&lm_lim)) {
                    cputs("lin_maestro: respuesta 0x11 con datos mal:");
                    cput_bytes(d, LIN_LEN);
                    cprintf(", se esperaba %02x %02x A5 5A\n", lm_cont, (uint8_t)~lm_cont);
                }
            } else {
                for (uint32_t i = 0; i <= LIN_LEN; i++) lm_ultima[i] = d[i];
                lm_hay_ultima = 1;
            }
            lm_fin(chk_ok && datos_ok);
        }
        break;
    }

    if (!lm_caido && (ticks - lm_t_ok) > LIN_RX_TIMEOUT_MS) {
        lm_caido = 1;
        lm_err_caida = lm_resp_err;
        cputs("lin_maestro: sin respuesta buena del esclavo hace 500 ms: revisar el cable LIN (J3-1) y GND, "
              "SW3 cerrado en esta placa y que la otra corra lin_esclavo\n");
    }

    if (lm_error || (ticks - lm_t_ok) > LIN_RX_TIMEOUT_MS) leds(1, 0);
    else gpio_poner(LED_PORT, LED_ROJO, 0);

    if ((ticks - lm_t_res) >= LM_RESUMEN_MS) {
        lm_t_res += LM_RESUMEN_MS;
        if (resumen_activo) {
            cprintf("lin_maestro: 0x10 enviadas %u/s  0x11 OK %u/s  err %u total",
                    lm_tx_count - lm_tx_res, lm_resp_ok - lm_ok_res, lm_resp_err);
            if (lm_hay_ultima) {
                cputs(" | ultima respuesta");
                cput_bytes(lm_ultima, LIN_LEN);
                cputs(" chk OK");
            }
            cprintf(" | eco err %u\n", lin_eco_err);
        }
        lm_tx_res = lm_tx_count;
        lm_ok_res = lm_resp_ok;
    }
}

static void lm_deinit(void)
{
    lin_hw_deinit();
}

static void lm_estado_imprimir(void)
{
    cprintf("  %u baud, tramas 0x10 enviadas %u\n", lin_baud, lm_tx_count);
    cprintf("  errores: sin respuesta %u, checksum %u, datos %u, eco %u, break %u\n",
            lm_e_sin_resp, lm_e_chk, lm_e_datos, lm_e_eco, lm_e_break);
}

static const prueba_t p_lin_maestro = {
    .nombre = "lin_maestro", .archivo = "LIN_Maestro",
    .descripcion = "LIN 19200 entre placas: manda 0x10 y pide 0x11 cada 50 ms (SW3 cerrado)",
    .init = lm_init, .step = lm_step, .deinit = lm_deinit, .estado = lm_estado_imprimir,
    .ok = &lm_resp_ok, .err = &lm_resp_err,
};
