Mateo-Opertti/ECU32/(commit log)

2026-10-31 Reorganize repo: new README, schematic/PCB PDFs, netlist
    - Rewrite README: overview, block diagram, connectors (J1/J3/J4/J7),
    full pinout verified against PI_3.NET, firmware bring-up notes,
    repo structure, gallery and project status.
    - Fix pinout: DO2 = PE0, DO3 = PC10; 1/OE drives DO1-DO4, 2/OE drives DI1-DI4.
    - Add schematic PDF (7 sheets), PCB layout PDF and netlist (Rev 1.0).
    - Add layout PNGs for the README.
    - Add folder structure with per-folder guides (hardware/, firmware/, docs/).
    - Add .gitignore for Altium, STM32CubeIDE and LaTeX.
2026-10-31 README: voltage levels per connector, DI jumper selection, Pinout link at top; drop known-limitations
2026-10-31 Update voltage specification in README
2026-10-31 README: describe ECU32 as a universal ECU; drop power-consumption claims
2026-10-31 README: match intro to 12 / 24 V
2026-10-31 README: J7 supports 12 V and 24 V
2026-10-31 Add bring-up firmware and document it in the README
    Bare-metal test programs for each peripheral (LEDs, DI/DO, ADC, CAN FD,
    LIN master/slave, PWM), selected from Src/main.c. CMake project for the
    STM32Cube VS Code extension; build/ is ignored, .settings/ is kept to pin
    toolchain versions.
2026-10-31 Add 3D STEP model and show the 3D render in the gallery
    [ECU32_Rev1.0.step]
2026-10-31 README: per-channel analog input ranges (AN1 5 V, AN2 3.3 V, AN3 12 V, AN4 24 V)
2026-10-31 Drop revision suffix from file names and links
    [ECU32.step]
2026-10-31 Add assembled board photos; remove revision references
2026-10-31 Add 3D-printed enclosure standoff (STL) and docs
    [separador.stl]
2026-10-31 README: enclosure as its own section
2026-10-31 Enclosure: 32 mm is the effective standoff length
2026-10-31 Add silkscreen pinout QR (with errata) and initial block diagram
2026-10-31 Add BOM with real component values (CSV and XLSX)
    [ECU32_BOM.csv, ECU32_BOM.xlsx]
2026-10-31 Add fabrication Gerbers and NC Drill sent to JLCPCB
2026-11-09 Firmware: add CAN master/slave board-to-board test apps
    CAN_Maestro.c and CAN_Esclavo.c test FDCAN1 between two boards in both
    directions, with a slave LED pattern driven by the received data.
    Selectable from Src/main.c; the active app is unchanged.
2026-11-09 Firmware: add CAN wake-up test and ESP32 serial link test
    CAN_Esclavo_WakeUp.c puts the MCU in Standby and wakes on CAN1 through
    WKUP3 (PE6), then blinks the green LED every 250 ms.
    ESP32_Serial.c sends ON/OFF over USART2 and the ESP32_LED_Serial sketch
    drives the ESP32 onboard LED from those commands.
    Both apps are selectable from Src/main.c; the active app is unchanged.
2026-11-09 Firmware README: document CAN board-to-board, wake-up and ESP32 tests
2026-11-09 Gallery: add enclosure photos and board video
2026-11-12 Firmware: add Universal firmware with console and CAN2 control link
    One program for both boards that runs any bring-up test without
    reflashing. Tests are picked from a serial console (USART1 on J1:
    TX = DO2/PE0, RX = DI2/PE1, 115200 8N1) or, on the slave board, from the
    master over CAN2.
    - Apps/Universal.c: single main(), boot sequence (DO low, console, then
    1/OE and 2/OE low), reset cause, command parser and test table
    - Apps/universal/: console with IRQ ring buffers, shared FDCAN driver
    (one kernel clock, per-instance message RAM), CAN2 link protocol
    (0x700 command, 0x701 reply, 0x702 slave console text), role stored
    in the last flash page, and one non-blocking module per test
    - T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
    [ADC.c, CAN_Esclavo.c, CAN_Esclavo_WakeUp.c, CAN_FD.c, CAN_Maestro.c, Digital.c, Digital_Loopback.c, Digital_Salidas.c]
2026-11-12 README: per-channel analog dividers, J1 alternate functions and Universal firmware
    - Analog inputs: new ranges (AN1 0-3,3 V, AN2 0-5 V, AN3 0-12 V,
    AN4 0-24 V) in J4, voltage levels and the ADC12 table, which now
    lists each divider (R series, R to GND, factor). Resistor values are
    still to be filled in.
    - Digital I/O: separate DI and DO tables with J1 pin, alternate
    functions and EXTI, plus the peripherals available on J1 and notes
    on what cannot be used through the unidirectional buffer.
    - Firmware section and boot notes updated for Universal.c (console on
    USART1 through U5, boot order for the /OE pins); an_mv[] is the MCU
    pin voltage.
    - BOM: R28, R33 and R35-R40 split into on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
    [ECU32_BOM.csv]
2026-11-12 Firmware: console reports for CAN and LIN tests, resumen and traza
    - can_maestro, can_esclavo, can_fd, lin_maestro and lin_esclavo print a
    one-line summary every second: frames per second, OK and error
    counts, round-trip time (can_maestro), sequence and light pattern
    (can_esclavo), last LIN response, and CAN bus state (TEC, REC,
    error active/passive/bus off)
    - Immediate warnings with the reason: peer stops answering or comes
    back, bad frame with the failing byte, sequence jumps, CAN state
    changes and bus off, LIN break/echo/timeout/checksum/data errors.
    At most one per second of each kind
    - "resumen on|off" silences the periodic reports of every test
    (warnings still show); "t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
    [Universal.c, consola.c, ecu32_placa.h, ecu32_regs.h, enlace.c, fdcan.c, p_adc.c, p_can_esclavo.c]
2026-11-12 Firmware: add combo test (ADC + LIN + crossed LEDs + CAN2 console)
    combo_maestro / combo_esclavo, started together with "par combo":
    - each board measures AN1-AN4 and sends them to the other over LIN
    (ID 0x20 master -> slave, 0x21 slave -> master, 8 bytes of mV,
    enhanced checksum); combo_maestro is the LIN commander
    - each board shows on its LEDs the selected input of the OTHER board
    (same thresholds as adc); both LEDs blink if LIN is lost for 500 ms
    - one-second summary with both ends' voltages and LIN counters; the
    slave's summary reaches the master console over CAN2 as [esclava]
    - warnings for LIN loss/recovery, checksum and echo errors; traza on
    prints every frame
    The ADC meas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
    [Universal.c, enlace.c, p_adc.c, p_combo.c, p_lin.c]
2026-11-12 README: J4 table with STM32 pins and note on the outdated schematic
    - J4 table lists the MCU pins (B11, A1, C1, A0) instead of 1-4
    - Note that the AN1/AN2 dividers were changed on the assembled board
    (AN1 0-3,3 V, AN2 0-5 V) and the schematic PDF still shows the old ones
    - Firmware README: same AN ranges, and the console shows MCU pin voltage
2026-11-12 README: J1 and J3 tables with STM32 pins
    J1 lists the MCU pin of each terminal (E0, B9, C12, C10, E5, E1, D2,
    C11) and J3 the TX / RX pins of each bus (LIN D8/D9, CAN2 B6/B5,
    CAN1 A12/A11), like the J4 table. Columns keep the physical order.
2026-11-12 README: drop part numbers in parentheses from Pinout headings
    - Pinout subsections are now plain titles: Selección de tensión de las
    entradas digitales, Entradas y salidas digitales, Entradas analógicas,
    CAN FD, LIN (part numbers are still in the Hardware table)
    - DI/DO table labels written as sentences instead of parentheses
    - Firmware README: same for Consola and CAN2 entre placas, links updated
    to the new anchors, and the boot-notes link fixed (#notas-de-arranque)
2026-11-12 Firmware: add Pruebas firmware for the test plan
    Apps/Pruebas.c is a second complete firmware (selected in Src/main.c)
    with everything in Universal plus what plan_pruebas_ecu.pdf needs from
    the firmware. The "plan" command maps each test ID to what to run.
    New tests:
    - es: outputs as level or configurable PWM (TIM4/TIM8/TIM16), input
    change reports and frequency via EXTI (DIG-01/02/03)
    - ai: analog inputs in connector volts and % FS, N-sample average and
    VDDA from VREFINT, divider factors stored in flash, "ref" error
    against the multimeter (AI-02)
    - banco_can: CAN1 <-> CAN2 on one board, both directions, classic or FD,
    N frames with sequence check and PASS/FAIL report (COM-02, VR)
    -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
    [ESP32_Pruebas.ino, Universal.c, ecu32_regs.h, enlace.c, fdcan.c, main.c, nucleo.c, nucleo_def.c]
2026-11-12 Firmware: measure the analog inputs with ADC1 or ADC2
    AN1..AN4 are ADC12_INx, so either converter can sample them. The ADC
    engine now takes the converter from adc_conv (ADC1 by default), and
    Pruebas adds "adc_conv 1|2" to switch it, even with a test running, so
    both converters get tested in AI-02. VDDA is still measured with ADC1
    because VREFINT is only wired to ADC1. adc and ai show which converter
    is in use. Universal keeps using ADC1.
2026-11-12 Firmware: add test plan checklist
    CHECKLIST_PRUEBAS.md follows the order of plan_pruebas_ecu.pdf. Each
    test lists its wiring, the Pruebas commands, the acceptance criterion
    and checkboxes for board A and board B, plus the VR procedure and a
    wiring summary by test. Linked from the firmware README.
